ragna1123/guiter_pickup_winder/README.md

# ピックアップ製造計画

## ワインダー

## ピックアップボビン&カバー

### ラインナップ

- TELECASTER
- JAZZMASTER
- P90

### 実装予定

- A90
- STRATCASTER
