ragna1123/guiter_pickup_winder/docs/lcd_menu_ui.md

# ギターピックアップワインダー LCD メニュー仕様

操作系：ロータリースイッチ

- 回す → 選択 / 数値変更 / 速度調整
- 押す → 決定 / 一時停止

---

## 起動

- バージョン表示
- → メニューへ

---

## メニュー

- フリーモード
- カウントモード
- 設定

---

## フリーモード

1. **回転方向選択**

   - FW / REV

2. **スタンバイ**

   - 表示：`スタンバイ中`
   - 操作：スタート

3. **ラン中**

   - 表示例：
     ```
     RUN FW
     Count:  1234
     Speed:   75%
     > 一時停止
     ```
   - Count … 累積カウント
   - Speed … 出力％（ロータリーで調整）
   - 押す … 一時停止へ

4. **一時停止中**
   - 再開
   - 終了

---

## カウントモード

1. **回転方向選択**

   - FW / REV

2. **回転数設定**

   - 表示：`回転数: 08000`
   - 入力：ロータリー回転速度で可変
     - 遅い → 1 刻み
     - 中速 → 10 刻み
     - 速い → 100 刻み

3. **スタンバイ**

   - 表示：`スタンバイ中`
   - 操作：スタート

4. **ラン中**

   - 表示例：
     ```
     RUN FW
     残り:   5678
     Speed:   80%
     > 一時停止
     ```
   - 残り … 設定回転数からのカウントダウン
   - Speed … 出力％（ロータリーで調整）

5. **一時停止中**

   - 再開
   - 終了

6. **完了**
   - 表示：`設定回転数が完了しました`
   - 操作：メニューへ戻る

---

## 設定メニュー

### Ver1 実装

- ソフトスタート／ストップ
- ブザー
  - ON/OFF
  - 音量調整（段階式）
- ディスプレイ
  - 明るさ
  - 省電力設定

### Ver2 以降（拡張案）

- プリセット回転数（登録／呼び出し）
- 最大連続稼働時間（安全用）
- 通知方法細分化（終了時のみ／一時停止時も）
