ragna1123/guiter_pickup_winder/docs/photo/1.jpeg

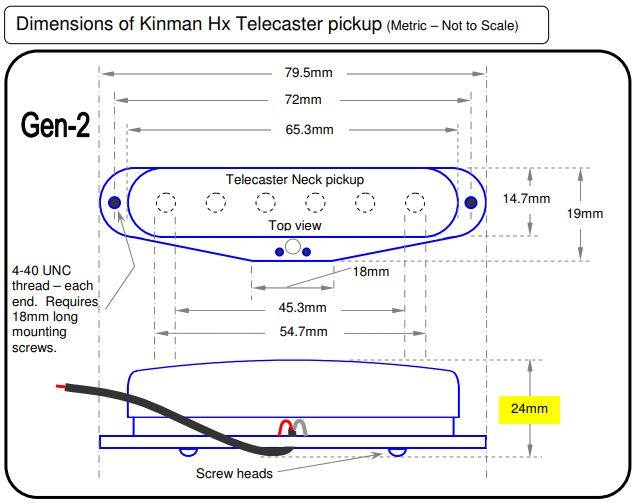
docs/photo/1.jpeg
