ragna1123/guiter_pickup_winder/docs/photo/2.jpeg

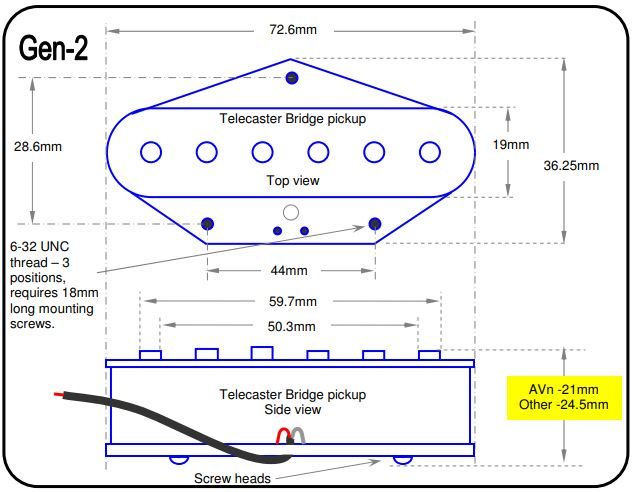
docs/photo/2.jpeg
