ragna1123/guiter_pickup_winder/docs/photo/S401794dd8af14fd29a98d5e5ec8555a4s.webp

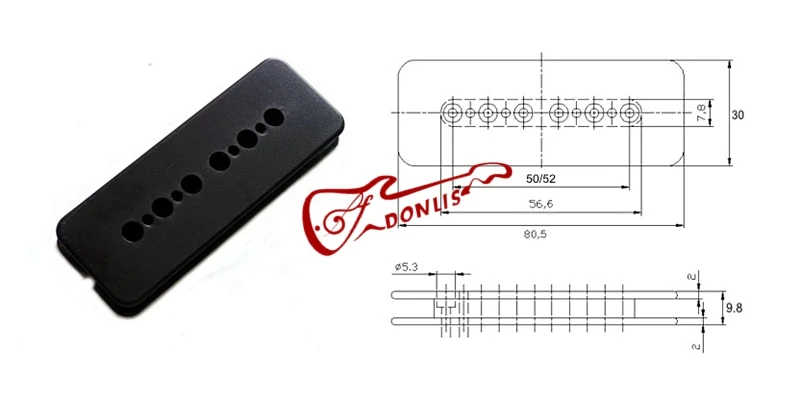
docs/photo/S401794dd8af14fd29a98d5e5ec8555a4s.webp
