ragna1123/guiter_pickup_winder/docs/winder_parts_info.md

# ピックアップワインダー作成 概算だし

## パーツ情報

- モーター

  - 長さ 60mm(ボディ 38mm)
  - 外径 27.6mm

- 軸

  - 径 12mm

- ベルト

  - 長さ 120mm
  - 線径 5.7mm

- ベアリング

  - 外径 28mm
  - 内径 12mm
  - 厚さ 8mm

- リードセンサ付きカウンター
  - 色々不明

## 3D プリント部品リスト

- プーリー(モーター側)

  - ベルト幅 6mm(5.7mm)
  - 外径 18-25mm
  - 内径 9.5mm
  - 10 枚

- プーリー(軸側)

  - 外径 100mm 75mm
  - 内径 12mm

- モーターマウント

  - マウント部径 27.6mm
  - 高さ　 60mm
  - テンションかけれる機構で

- マグネットマウント

  - 内径 12mm

- ベアリングピロー

  - ベアリングマウント内径 28mm

- ピックアップチャック
  - 外径 100mm
