ragna1123/guiter_pickup_winder/cad/winder/PCB/winder_led/winder_led.step

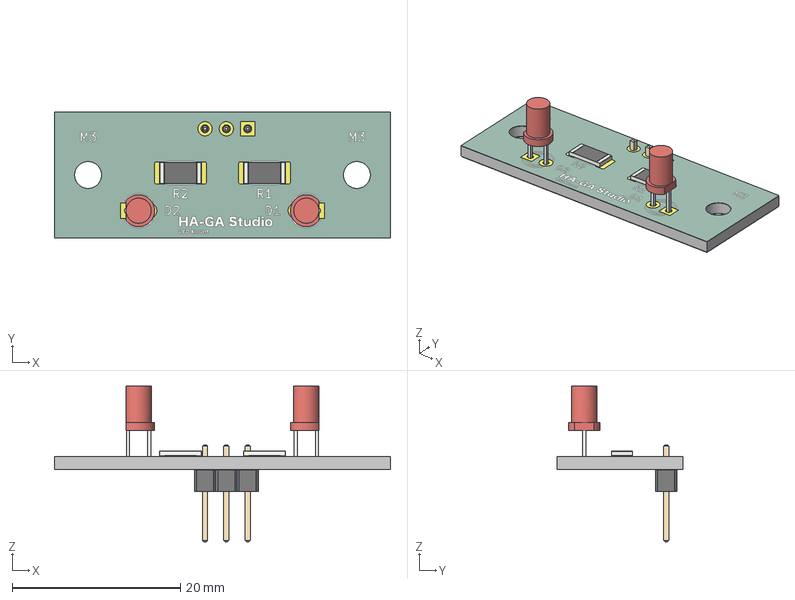
[picture p4: CAD file, 2025-12-04]
cad/winder/PCB/winder_led/winder_led.step
40.0 x 15.0 x 18.5 mm
R_2010_5025Metric x 2
LED_D3.0mm_FlatTop x 2
PinHeader_1x03_P2.54mm_Vertical
winder_led_copper
winder_led_silkscreen x 2
winder_led_soldermask x 2
winder_led_PCB
