ragna1123/guiter_pickup_winder/cad/winder/PCB/winder_pcb/re_winder_pcb.step

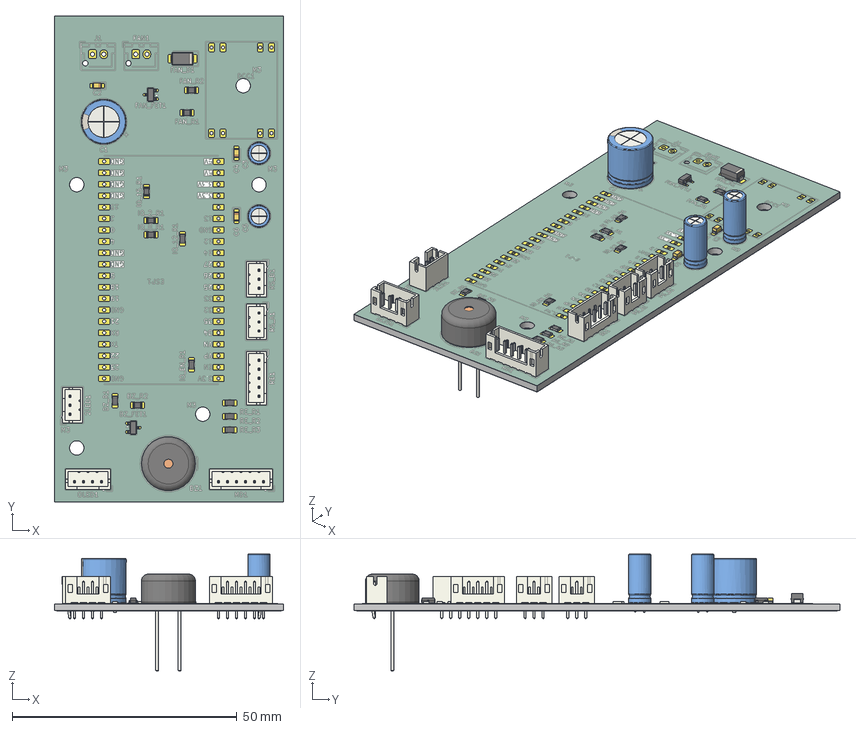
[picture p5: CAD file, 2025-12-04]
cad/winder/PCB/winder_pcb/re_winder_pcb.step
51.0 x 108.0 x 26.0 mm
C_Radial_D5.0mm_H11.0mm_P2.00mm x 2
R_0805_2012Metric x 12
JST_PH_B3B-PH-K_1x03_P2.00mm_Vertical x 3
CP_EIA-2012-12_Kemet-R x 3
Buzzer_TDK_PS1240P02BT_D12.2mm_H6.5mm
D_SMA
JST_PH_B4B-PH-K_1x04_P2.00mm_Vertical
SOT-23 x 2
CP_Radial_D10.0mm_P5.00mm
JST_PH_B6B-PH-K_1x06_P2.00mm_Vertical
JST_PH_B5B-PH-K_1x05_P2.00mm_Vertical
re_winder_pcb_copper
re_winder_pcb_silkscreen
re_winder_pcb_soldermask x 2
re_winder_pcb_PCB
