ragna1123/guiter_pickup_winder/cad/winder/PCB/winder_power/winder_power/guitar_winder_power.step

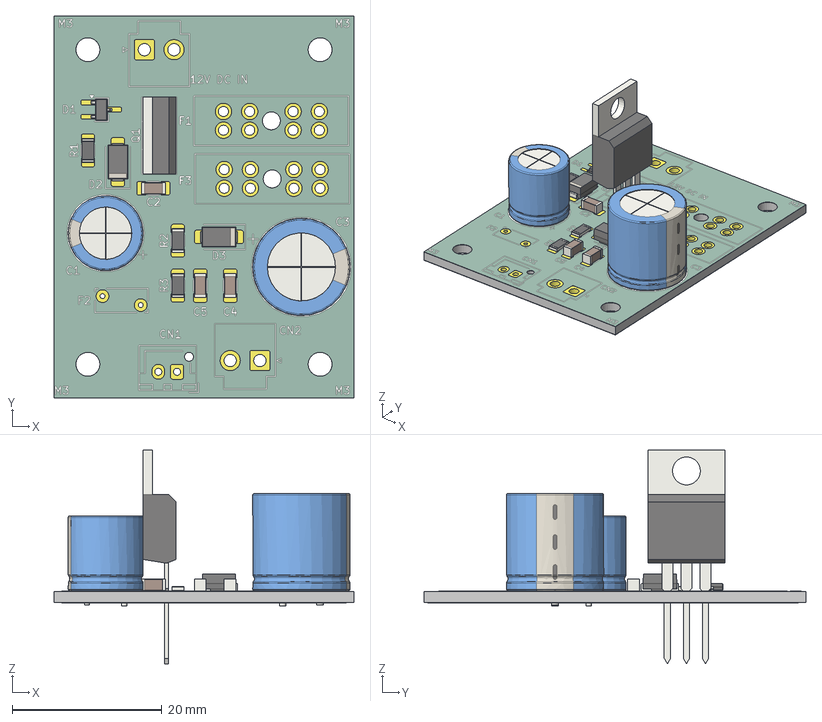
[picture p6: CAD file, 2026-06-18]
cad/winder/PCB/winder_power/winder_power/guitar_winder_power.step
40.0 x 51.0 x 28.5 mm
R_1206_3216Metric x 3
D_SMA x 2
TSOT-23
C_1206_3216Metric x 3
TO-220-3_Vertical
CP_Radial_D10.0mm_P5.00mm
CP_Radial_D13.0mm_P5.00mm
Untitled_copper
Untitled_silkscreen
Untitled_soldermask x 2
Untitled_PCB
