ragna1123/guiter_pickup_winder/cad/winder/test/test_parts_v1.stl

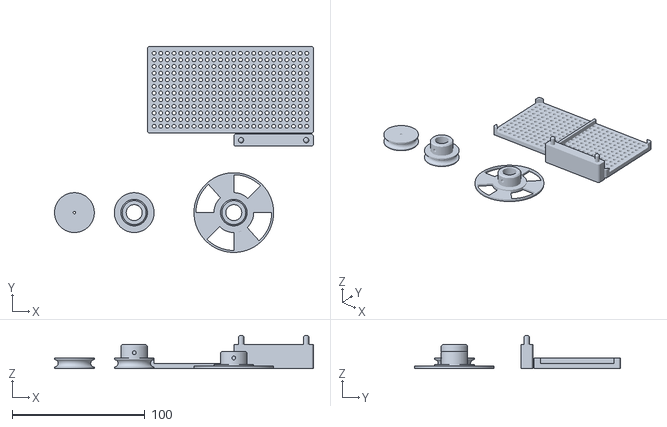
[picture p7: CAD file, 2025-10-12]
cad/winder/test/test_parts_v1.stl
195.0 x 155.0 x 25.0
