ragna1123/guiter_pickup_winder/mfg/pickup/JM/JM_10_2mm_v2.stl

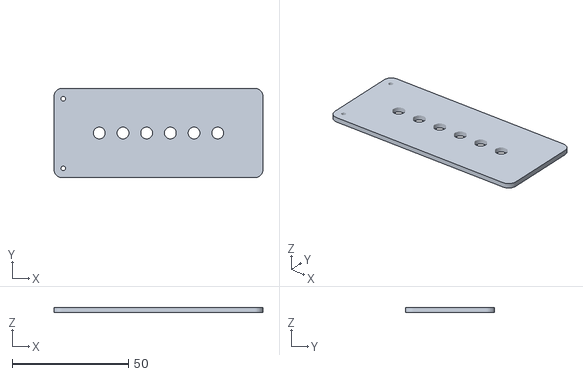
[picture p8: CAD file, 2025-09-22]
mfg/pickup/JM/JM_10_2mm_v2.stl
90.0 x 38.5 x 2.00
