ragna1123/guiter_pickup_winder/mfg/pickup/P90/P90-50mm v2.stl

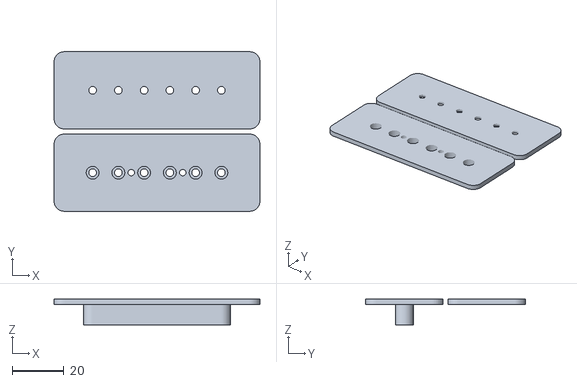
[picture p9: CAD file, 2025-09-22]
mfg/pickup/P90/P90-50mm v2.stl
80.0 x 62.0 x 10.0
