ragna1123/guiter_pickup_winder/mfg/pickup/TELE/tele_rear_mount_nonwall_v1.stl

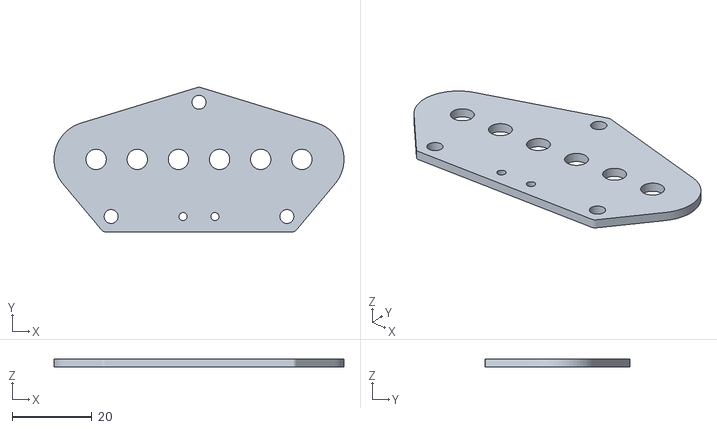
[picture p10: CAD file, 2025-09-22]
mfg/pickup/TELE/tele_rear_mount_nonwall_v1.stl
72.6 x 36.2 x 2.00
