ragna1123/guiter_pickup_winder/mfg/winder/test/test_parts_v1.stl

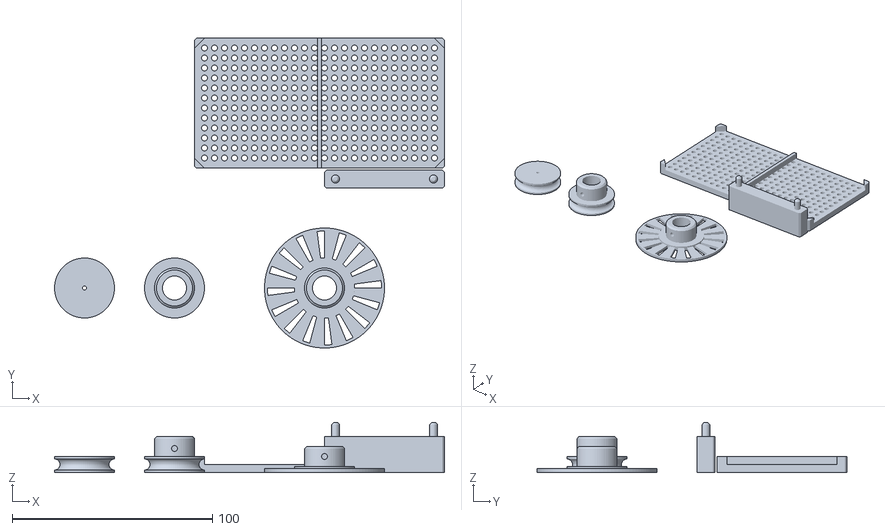
[picture p11: CAD file, 2025-10-12]
mfg/winder/test/test_parts_v1.stl
195.0 x 155.0 x 25.0
