ragna1123/guiter_pickup_winder/mfg/winder/v1.1/ワインダー量産試作機.stl

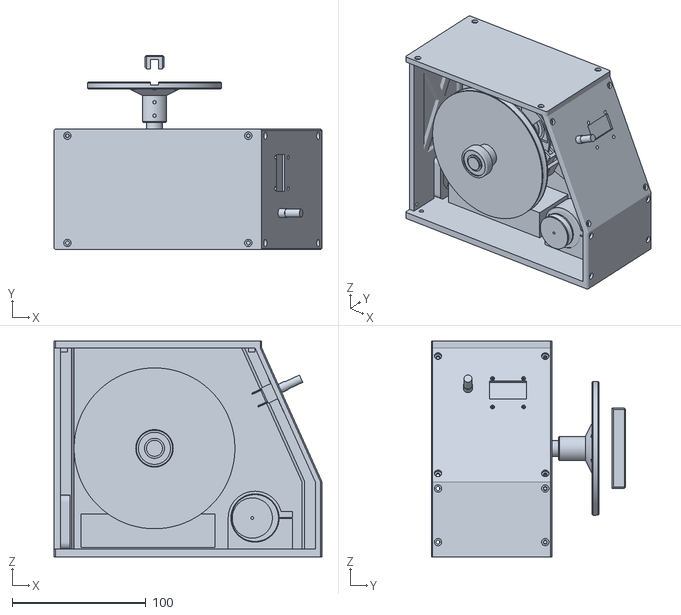
[picture p12: CAD file, 2025-10-12]
mfg/winder/v1.1/ワインダー量産試作機.stl
200.0 x 145.0 x 161.0
