ragna1123/guiter_pickup_winder/mfg/winder/test/仮シャフト.stl

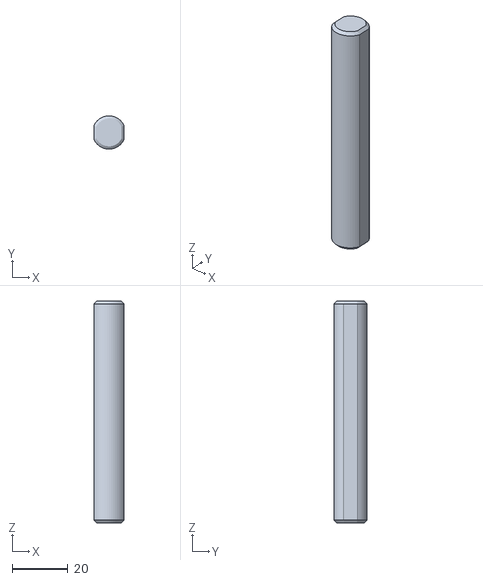
[picture p14: CAD file, 2025-09-27]
mfg/winder/test/仮シャフト.stl
11.0 x 12.0 x 80.0
