ragna1123/guiter_pickup_winder/mfg/pickup/TELE/tele_rear_body v2.stl

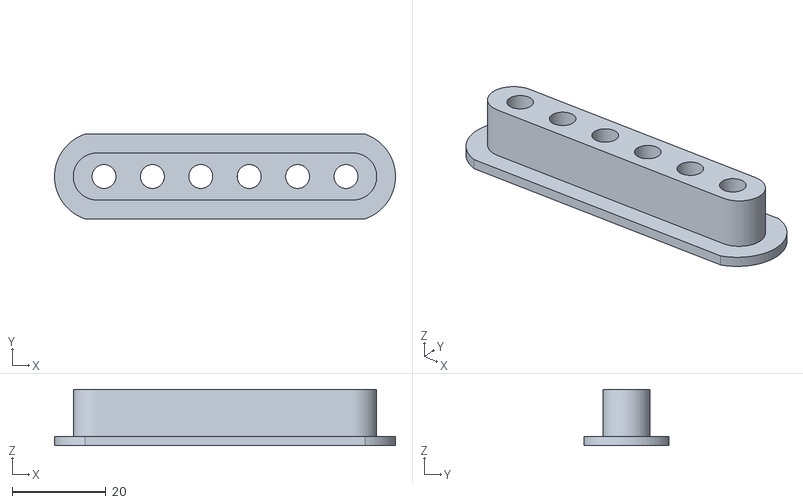
[picture p15: CAD file, 2025-09-22]
mfg/pickup/TELE/tele_rear_body v2.stl
72.6 x 18.0 x 12.0
