ragna1123/guiter_pickup_winder/mfg/winder/test/スペーサ４.stl

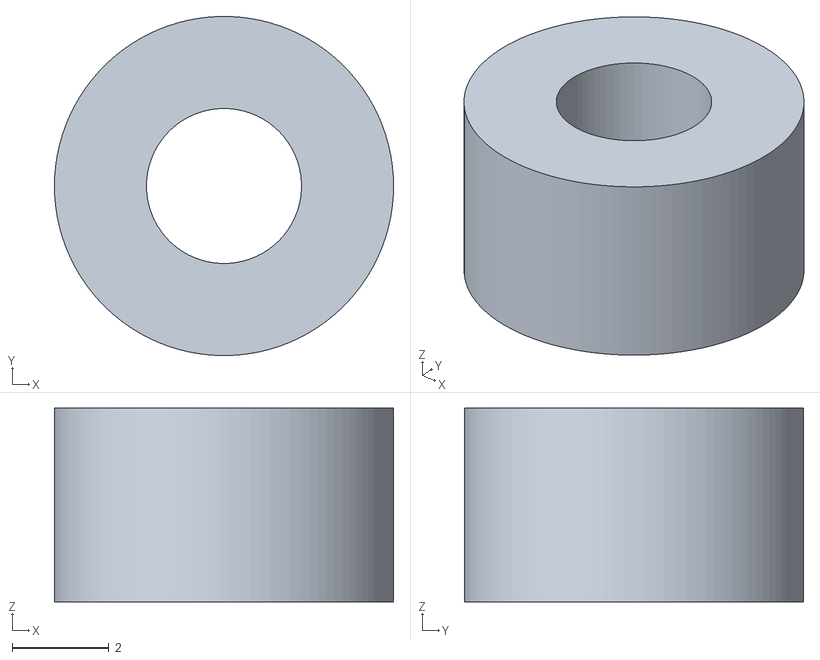
[picture p16: CAD file, 2025-09-27]
mfg/winder/test/スペーサ４.stl
7.00 x 7.00 x 4.00
