ragna1123/guiter_pickup_winder/mfg/winder/test/スペーサ4_5.stl

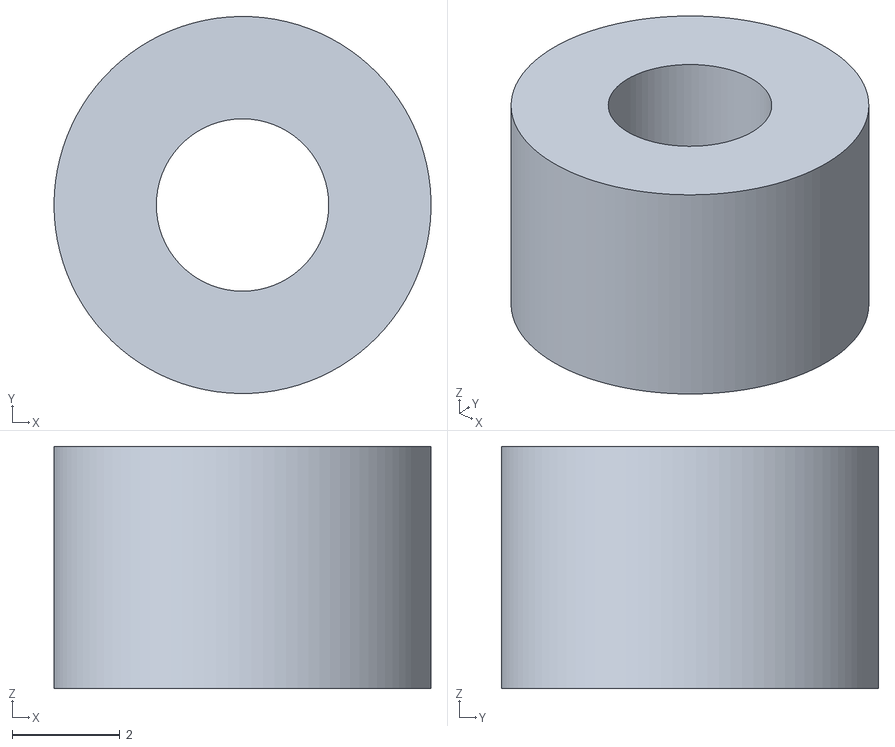
[picture p17: CAD file, 2025-09-27]
mfg/winder/test/スペーサ4_5.stl
7.00 x 7.00 x 4.50
