ragna1123/guiter_pickup_winder/mfg/winder/test/スペーサ.stl

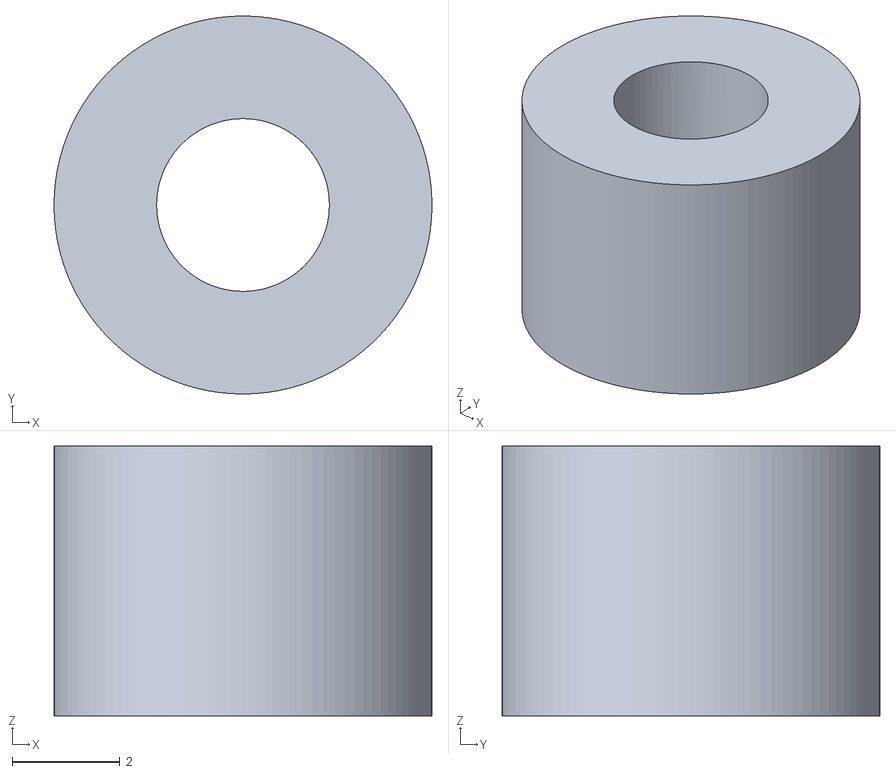
[picture p18: CAD file, 2025-09-27]
mfg/winder/test/スペーサ.stl
7.00 x 7.00 x 5.00
