ragna1123/guiter_pickup_winder/mfg/winder/v1/モーターマウント(ベース).stl

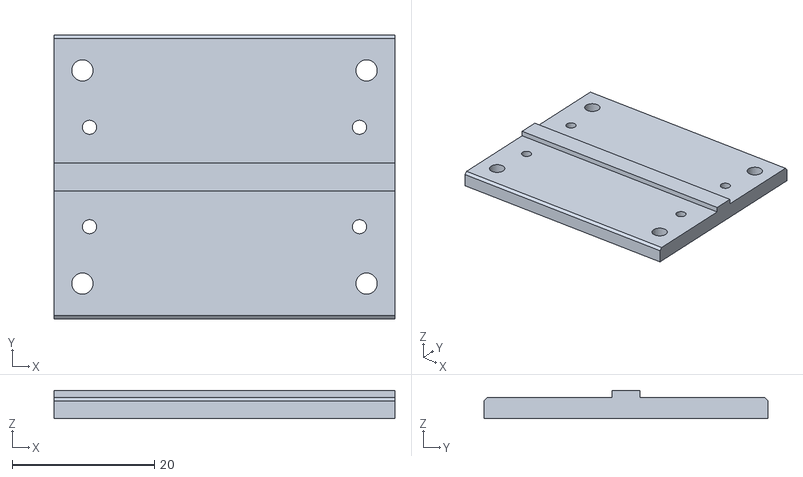
[picture p19: CAD file, 2025-09-27, an earlier design]
mfg/winder/v1/モーターマウント(ベース).stl
48.0 x 40.0 x 4.00
