ragna1123/guiter_pickup_winder/(list of files, cad)

Other CAD files:
cad/winder/PCB/winder_power/winder_power/guiter_winder_power.step
mfg/pickup/TELE/tele_rear_mount v2.stl
cad/pick_up/JM/JM_pickup.f3d
cad/pick_up/JM/JM_pickup_v2.f3d
cad/pick_up/P90/P90-50mm v1.f3d
cad/pick_up/P90/P90-50mm v2.f3d
cad/pick_up/TELE/tele_rear_body v1 v2.f3d
cad/pick_up/TELE/tele_rear_body v1.f3d
cad/pick_up/TELE/tele_rear_body v2.f3d
cad/pick_up/TELE/tele_rear_body_nonwall_v1.f3d
cad/pick_up/TELE/tele_rear_mount v2.f3d
cad/pick_up/TELE/tele_rear_mount_nonwall_v1.f3d
cad/winder/test/test_parts_v1.f3d
cad/winder/test/仮シャフト.f3d
cad/winder/v1.1/パーツ/ピックアップチャッキ.f3d
cad/winder/v1.1/パーツ/プーリー＆センサスリット.f3d
cad/winder/v1.1/パーツ/モーターマウント.f3d
cad/winder/v1.1/パーツ/ワインダー量産試作機外装作成前配置.f3z
cad/winder/v1.1/ワインダー量産試作機 v3.f3z
cad/winder/v1.1/ワインダー量産試作機.f3z
cad/winder/v1/ピックアップチャッキ.f3d
cad/winder/v1/モーターマウント(ベース).f3d
cad/winder/v1/モーターマウント(内部).f3d
cad/winder/v1/モーターマウント(外側).f3d
cad/winder/v1/リードマグネットマウント.f3d
mfg/pickup/JM/JM_10_2mm_v1.stl
mfg/pickup/P90/P90-50mm v1.stl
mfg/pickup/TELE/tele_rear_body v1 v2.stl
mfg/pickup/TELE/tele_rear_body v1.stl
mfg/winder/v1/ピックアップチャッキ.stl
mfg/winder/v1/プーリー(モーター側).stl
mfg/winder/v1/プーリー(軸側).stl
mfg/winder/v1/ベアリングピロー.stl
mfg/winder/v1/モーターマウント(内部).stl
mfg/winder/v1/モーターマウント(外側).stl
mfg/winder/v1/リードマグネットマウント.stl
