ragna1123/guiter_pickup_winder/docs/photo/Tele_Single_Coil_6aa47ca.pdf

# TELE SINGLE COIL COMPONENT DIMENSIONS

## Bare Knuckle

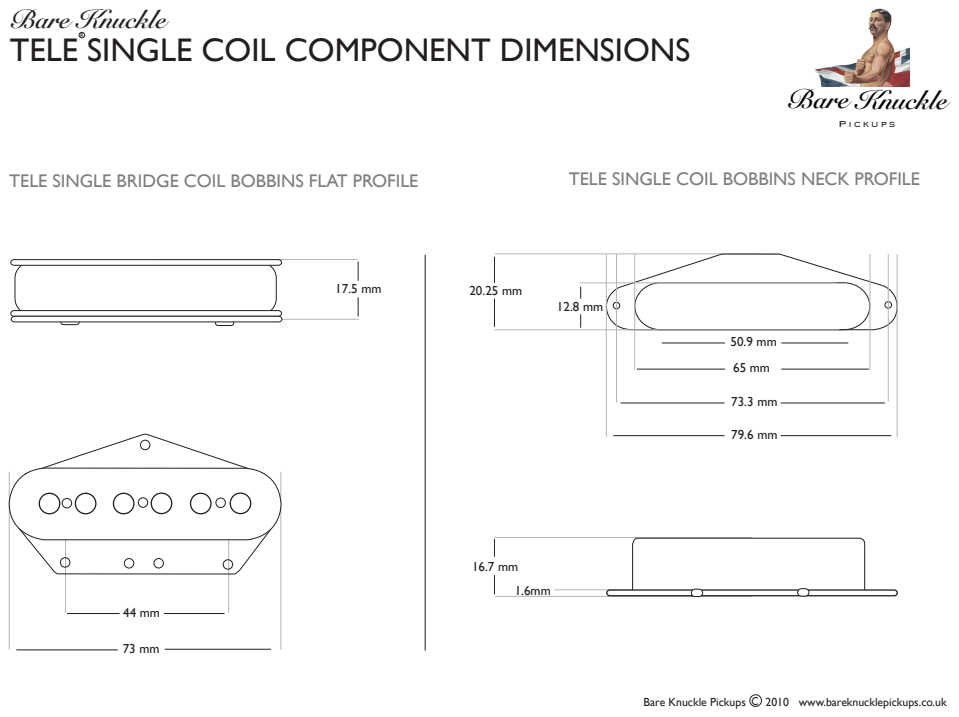
[picture p20: page 1]
Bare Knuckle Pickups; 2010 www.bareknucklepickups.co.uk; Bare Knuckle; Pickups

TELE SINGLE BRIDGE COIL BOBBINS FLAT PROFILE

TELE SINGLE COIL BOBBINS NECK PROFILE
