ragna1123/guiter_pickup_winder/cad/winder/PCB/winder_power/winder_power/Untitled.kicad_pcb

## KiCad design cad/winder/PCB/winder_power/winder_power/Untitled.kicad_pcb (2026-06-18)

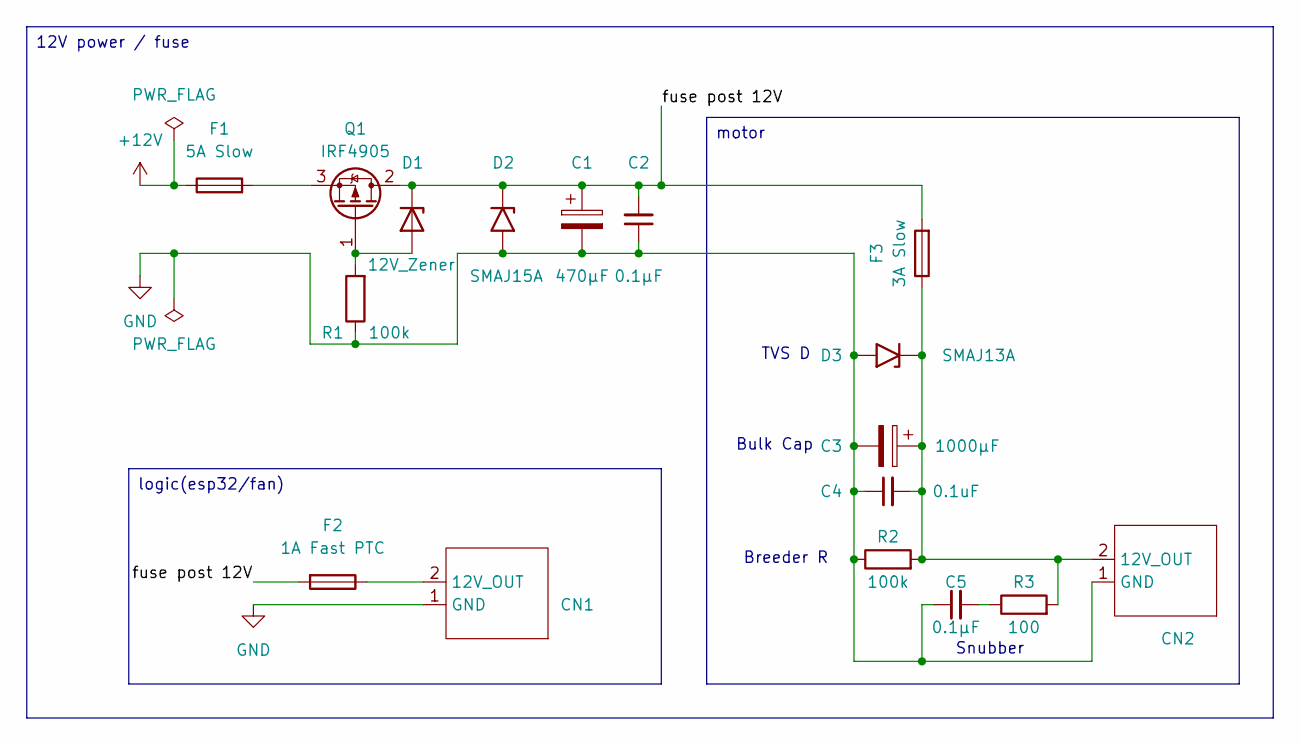
[picture p21: schematic Untitled.kicad_sch]

Parts:
C1: 470µF; CP_Radial_D10.0mm_P5.00mm
C2, C5: 0.1µF; C_1206_3216Metric_Pad1.33x1.80mm_HandSolder
C3: 1000µF; CP_Radial_D13.0mm_P5.00mm
C4: 0.1uF; C_1206_3216Metric_Pad1.33x1.80mm_HandSolder
CN1: JST_XH_B2B-XH-AM_1x02_P2.50mm_Vertical
CN2: JST_VH_B2P-VH-B_1x02_P3.96mm_Vertical
D1: 12V_Zener; TSOT-23_HandSoldering
D2: SMAJ15A; D_SMA
D3: SMAJ13A; D_SMA
F1: 5A Slow; FuseHolder_Blade_ATO_Littelfuse_FLR_178.6165
F2: 1A Fast PTC; Fuse_Bourns_MF-RHT070
F3: 3A Slow; FuseHolder_Blade_ATO_Littelfuse_FLR_178.6165
Q1: IRF4905; TO-220-3_Vertical
R1, R2: 100k; R_1206_3216Metric_Pad1.30x1.75mm_HandSolder
R3: 100; R_1206_3216Metric_Pad1.30x1.75mm_HandSolder

Connections:
+12V: F1.1; also elsewhere on the board
/fuse post 12V: C1.1, C2.2, D1.1 (K), D2.1 (A1), F2.2, F3.2, Q1.2 (D)
GND: C1.2, C2.1, C3.2, C4.1, C5.1, CN1.1 (GND), CN2.1 (GND), D2.2 (A2), D3.2 (A2), R1.1, R2.1; also elsewhere on the board
unnamed: C5.2, R3.1
unnamed: CN1.2 (12V_OUT), F2.1
unnamed: C3.1, C4.2, CN2.2 (12V_OUT), D3.1 (A1), F3.1, R2.2, R3.2
unnamed: D1.2 (A), Q1.1 (G), R1.2
unnamed: F1.2, Q1.3 (S)

Notes on the sheet:
Bulk Cap
Breeder R
TVS D
Snubber
logic(esp32/fan)
12V power / fuse
motor

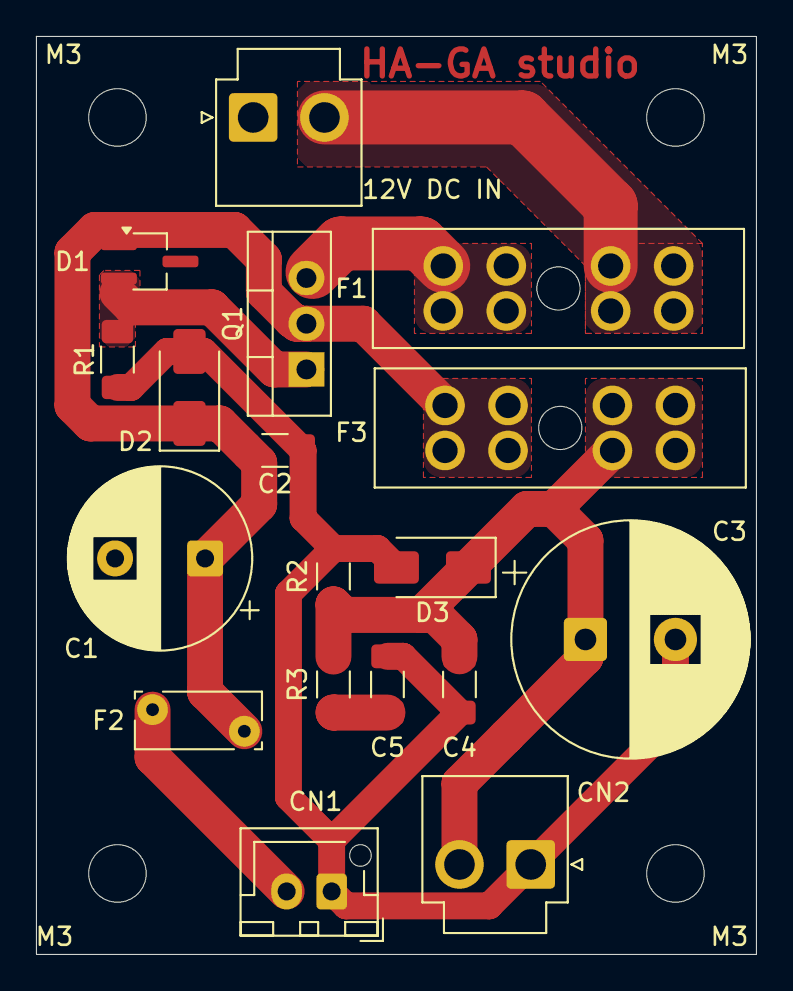
[picture p22: board Untitled.kicad_pcb from above]

Board: 2 copper layers, 40.0 x 51.0 mm, 22 parts (0 on the bottom side), 8 nets.

Other parts of the board:
12V DC IN: JST_VH_B2P-VH-B_1x02_P3.96mm_Vertical
M3, M3#2, M3#3, M3#4: MountingHole_3.2mm_M3

Their connections:
+12V: 12V DC IN.2; also elsewhere on the board
GND: 12V DC IN.1; also elsewhere on the board
