ragna1123/guiter_pickup_winder/cad/winder/PCB/winder_led/winder_led.kicad_pcb

## KiCad design cad/winder/PCB/winder_led/winder_led.kicad_pcb (2026-06-18)

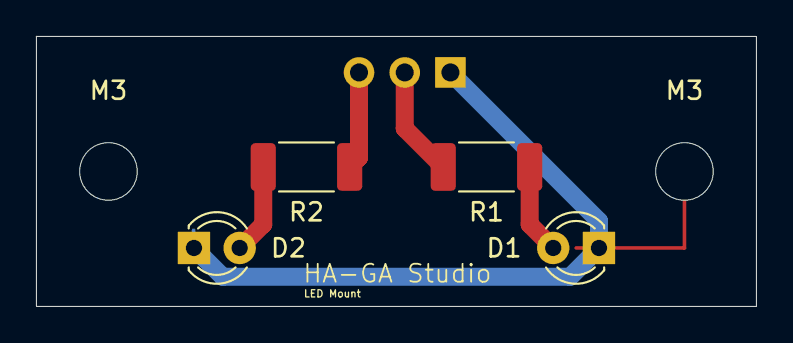
[picture p23: board winder_led.kicad_pcb from above]

Board: 2 copper layers, 40.0 x 15.0 mm, 7 parts (1 on the bottom side), 5 nets.

Parts:
D1, D2: LED; LED_D3.0mm_FlatTop
J1: PinHeader_1x03_P2.54mm_Vertical
M3, M3#2: MountingHole_3.2mm_M3
R1, R2: R_Small; R_2010_5025Metric_Pad1.40x2.65mm_HandSolder

Connections:
/GPIO4: J1.2, R1.1
/GPIO5: J1.3, R2.1
GND: D1.1 (K), D2.1 (K), J1.1
unnamed: D1.2 (A), R1.2
unnamed: D2.2 (A), R2.2
