ragna1123/guiter_pickup_winder/cad/winder/PCB/winder_pcb/re_winder_pcb.kicad_pcb

## KiCad design cad/winder/PCB/winder_pcb/re_winder_pcb.kicad_pcb (2026-06-18)

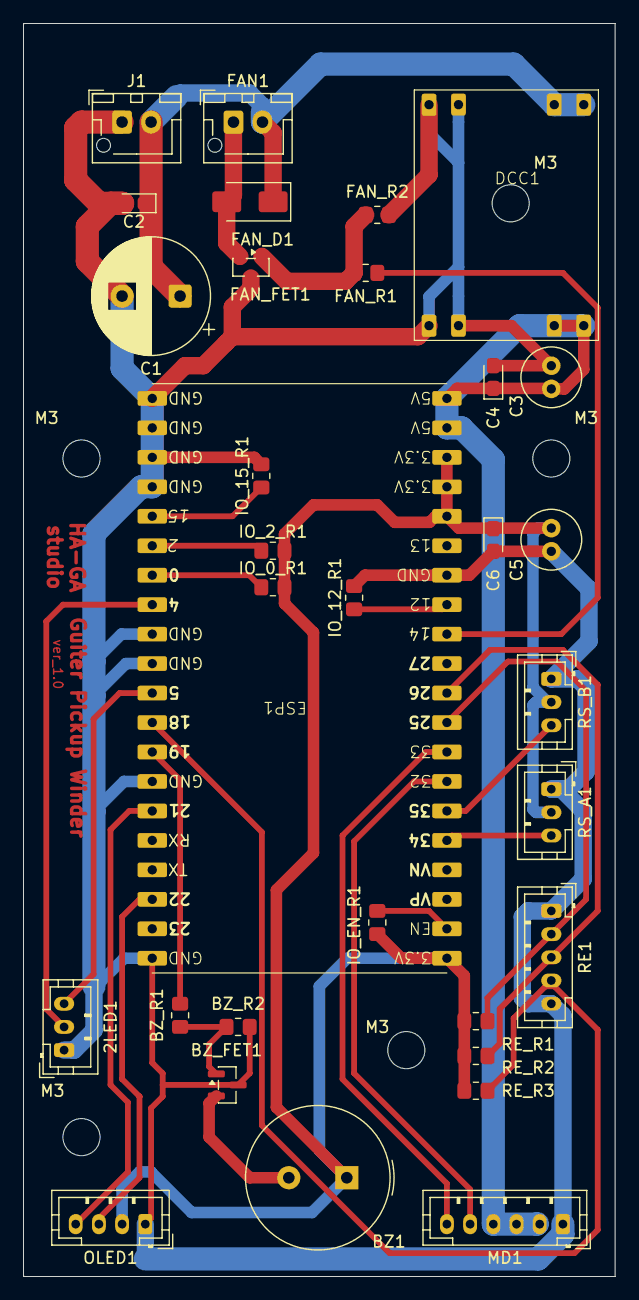
[picture p24: board re_winder_pcb.kicad_pcb from above]

Board: 2 copper layers, 51.0 x 108.0 mm, 37 parts (0 on the bottom side), 26 nets.

Parts:
2LED1: LED; JST_PH_B3B-PH-K_1x03_P2.00mm_Vertical
BZ1: Buzzer; Buzzer_TDK_PS1240P02BT_D12.2mm_H6.5mm
BZ_FET1: AO3400A; SOT-23
BZ_R1: 100_R; R_0805_2012Metric_Pad1.20x1.40mm_HandSolder
BZ_R2: 100K_R; R_0805_2012Metric_Pad1.20x1.40mm_HandSolder
C1: 470uF; CP_Radial_D10.0mm_P5.00mm
C2, C4, C6: 0.1uF; CP_EIA-2012-12_Kemet-R_HandSolder
C3: 47uF; C_Radial_D5.0mm_H11.0mm_P2.00mm
C5: 10uF; C_Radial_D5.0mm_H11.0mm_P2.00mm
DCC1: DC_DW; MP1584EN_DCDC_Converter
ESP1: ESP32_Freenove_Socket
FAN1: 12V_Fan; JST_XH_B2B-XH-AM_1x02_P2.50mm_Vertical
FAN_D1: SS14; D_SMA
FAN_FET1: AO3400A; SOT-23
FAN_R1: 100_R; R_0805_2012Metric_Pad1.20x1.40mm_HandSolder
FAN_R2: 100K_R; R_0805_2012Metric_Pad1.20x1.40mm_HandSolder
IO_0_R1, IO_2_R1, IO_12_R1, IO_15_R1: 10K_R; R_0805_2012Metric_Pad1.20x1.40mm_HandSolder
IO_EN_R1: 10K_R; R_0805_2012Metric_Pad1.20x1.40mm_HandSolder
J1: 12V_IN; JST_XH_B2B-XH-AM_1x02_P2.50mm_Vertical
M3, M3#2, M3#3, M3#4, M3#5: MountingHole_3.2mm_M3
MD1: JST_PH_B6B-PH-K_1x06_P2.00mm_Vertical
OLED1: JST_PH_B4B-PH-K_1x04_P2.00mm_Vertical
RE1: RotaryEncoder_Switch; JST_PH_B5B-PH-K_1x05_P2.00mm_Vertical
RE_R1, RE_R2, RE_R3: 10K_R; R_0805_2012Metric_Pad1.20x1.40mm_HandSolder
RS_A1: JST_PH_B3B-PH-K_1x03_P2.00mm_Vertical
RS_B1: JST_PH_B3B-PH-K_1x03_P2.00mm_Vertical

Connections:
+5V: C3.1, C4.1, DCC1.4 (V_OUT+), ESP1.2 (5V), MD1.2 (VCC), MD1.3 (R_EN), MD1.4 (L_EN)
+12V: C1.1, C2.1, DCC1.2 (V_IN+), FAN1.2 (+), FAN_D1.1 (K), J1.2
/+3.3V: BZ1.1 (+), C5.1, C6.1, ESP1.3 (3.3V), IO_0_R1.2, IO_2_R1.2, IO_EN_R1.2, OLED1.2 (VCC), RE_R1.1, RE_R2.2, RE_R3.2, RS_A1.2 (VCC), RS_B1.2 (VCC)
/GPIO_4: 2LED1.2 (FW_LED), ESP1.25 (4)
/GPIO_5: 2LED1.3 (REV_LED), ESP1.24 (5)
/GPIO_14: ESP1.12 (14), FAN_R1.1
/GPIO_18: ESP1.23 (18), RE1.4 (S1), RE_R3.1
/GPIO_19: BZ_R1.2, ESP1.22 (19)
/GPIO_21: ESP1.21 (21/I2C(SDA)), OLED1.4 (SDA)
/GPIO_22: ESP1.20 (22/I2C(SCL)), OLED1.3 (SCL)
/GPIO_25: ESP1.9 (25), RE1.2 (A), RE_R1.2
/GPIO_26: ESP1.10 (26), RE1.3 (B), RE_R2.1
/GPIO_32: ESP1.7 (32), MD1.5 (R_PWM)
/GPIO_33: ESP1.8 (33), MD1.6 (L_PWM)
/GPIO_34: ESP1.5 (34), RS_A1.3 (DO)
/GPIO_35: ESP1.6 (35), RS_B1.3 (DO)
GND: 2LED1.1 (GND), BZ_FET1.3 (D), BZ_R2.1, C1.2, C2.2, C3.2, C4.2, C5.2, C6.2, DCC1.1 (V_IN-), DCC1.3 (V_OUT-), ESP1.1 (GND), FAN_FET1.3 (D), FAN_R2.2, IO_12_R1.2, IO_15_R1.2, J1.1, MD1.1 (GND), OLED1.1 (GND), RE1.1 (C), RE1.5 (S2), RS_A1.1 (GND), RS_B1.1 (GND)
unnamed: BZ1.2 (-), BZ_FET1.2 (S)
unnamed: BZ_FET1.1 (G), BZ_R1.1, BZ_R2.2
unnamed: ESP1.26 (0/Boot), IO_0_R1.1
unnamed: ESP1.27 (2), IO_2_R1.1
unnamed: ESP1.13 (12), IO_12_R1.1
unnamed: ESP1.28 (15), IO_15_R1.1
unnamed: ESP1.4 (EN), IO_EN_R1.1
unnamed: FAN1.1 (-), FAN_D1.2 (A), FAN_FET1.2 (S)
unnamed: FAN_FET1.1 (G), FAN_R1.2, FAN_R2.1
