ragna1123/guiter_pickup_winder/(commit log)

2025-08-28 雛形生成
2025-08-30 CAD作成
    [ピックアップチャッキ.f3d, ピックアップチャッキ.stl, プーリー(モーター側).stl, プーリー(軸側).stl, ベアリングピロー.stl, モーターマウント(ベース).f3d, モーターマウント(ベース).stl, モーターマウント(内部).f3d]
2025-08-30 ブランチ切り替え
2025-08-30 画像の追加
2025-09-14 pick_upパーツを追加
    [P90-50mm v1.f3d, P90-50mm v1.stl, tele_rear_body v1 v2.f3d, tele_rear_body v1 v2.stl, tele_rear_body v1.f3d, tele_rear_body v1.stl, tele_rear_body v2.stl, tele_rear_mount v2.f3d]
2025-09-14 ジャズマスターパーツを追加
    [JM_10_2mm_v1.stl, JM_pickup.f3d, P90-50mm v1.stl, tele_rear_body v1 v2.stl, tele_rear_body v1.stl, tele_rear_body v2.stl, tele_rear_mount v2.stl]
2025-09-14 doc整理
2025-09-17 v2モデルをアップ
    [JM_10_2mm_v1.stl, JM_pickup.f3d, P90-50mm v1.f3d, P90-50mm v1.stl, tele_rear_body v1 v2.f3d, tele_rear_body v1 v2.stl, tele_rear_body v1.f3d, tele_rear_body v1.stl]
2025-09-22 チャッキの抑え機構追加
    [ピックアップチャッキ.f3d, ピックアップチャッキ.stl]
2025-09-24 docにlcd_menuを追加
2025-09-27 test modelの追加
    [test_parts_v1.f3d, test_parts_v1.stl, スペーサ.stl, スペーサ4_5.stl, スペーサ４.stl, モーターマウント(ベース).f3d, モーターマウント(ベース).stl, 仮シャフト.f3d]
2025-10-12 筐体を作成
    [JM_10_2mm_v1.stl, JM_10_2mm_v2.stl, P90-50mm v1.stl, P90-50mm v2.stl, tele_rear_body v1 v2.stl, tele_rear_body v1.stl, tele_rear_body v2.stl, tele_rear_body_nonwall_v1.stl]
2025-10-27 基盤周りのアップ
    [re_winder_pcb.kicad_pcb, re_winder_pcb.kicad_sch, re_winder_pcb.step, winder_led.kicad_pcb, winder_led.kicad_sch, winder_led.step]
2025-12-04 パワー基盤の作成完了
    [Untitled.kicad_pcb, Untitled.kicad_sch, guiter_winder_power.step, re_winder_pcb.kicad_pcb, re_winder_pcb.kicad_sch]
2026-01-06 パーツリストMDを作成
    [Untitled-B_Cu.gbr, Untitled-B_Mask.gbr, Untitled-B_Paste.gbr, Untitled-B_Silkscreen.gbr, Untitled-Edge_Cuts.gbr, Untitled-F_Cu.gbr, Untitled-F_Mask.gbr, Untitled-F_Paste.gbr]
2026-01-14 パーツリスト出し
2026-06-18 Fix winder asset naming and BOM units
    [Untitled-B_Cu.gbr, Untitled-B_Mask.gbr, Untitled-B_Paste.gbr, Untitled-B_Silkscreen.gbr, Untitled-Edge_Cuts.gbr, Untitled-F_Cu.gbr, Untitled-F_Mask.gbr, Untitled-F_Paste.gbr]
